riban-bw/I2C-Hardware-Controller/(threads)

Thread 1 (2019-03-10):

Feature: Ability to configure I2C bus address

riban-bw, 2019-03-10:
It may be advantageous to configure the I2C address at boot time instead of at compile time, e.g. using dip switches.

riban-bw, 2019-03-25:
Added boot-time configuration switch inputs. I2C address may be configured to any value in range 0x08 - 0x47,

Closed 2019-03-25.

Thread 2 (2019-03-10):

Feature: Ability to configure controller parameters

riban-bw, 2019-03-10:
It may be advantageous to be able to send I2C messages to the device to configure its behaviour, e.g. to set the threshold and scaling of fast encoder rotation.

Thread 3 (2019-03-10):

Add schematic diagram

riban-bw, 2019-03-10:
The schematic circuit diagram should be added to repository.

riban-bw, 2019-03-25:
Schematic added - wip but progressing.

Closed 2019-03-25.

Thread 4 (2019-03-12):

Do not get full scale value through ADC multiplexer

riban-bw, 2019-03-12:
With a potentiometer turned fully up one would expect the ADC reading to be (2^n)-1 (where n is the quantity of bits), e.g. 0x3ff (1023) for 10-bits. This is true with a potentiometer directly feeding an ADC input pin but when a HCF4051BE multiplexer is inserted between the potentiometer and the ADC input pin then the ADC reads a maximum of 0x3d1 (977).

This may be due to impedance of the multiplexer. Need to check the datasheet and do some old-school Thevenin calculations. May be able to add a scaling factor or define a maximum expected value. May be related to the type of multiplexer chip used (just one in the drawer). It may be due to the resistor matrix arrangement. There may be some optimisation possible via code or hardware.

Thread 5 (2019-03-12):

Potentiometer value can be one off target

riban-bw, 2019-03-12:
Setting potentiomter fully up should result in the highest possible value but sometimes it provides a value one less than maximum. This may be after fast or slow movement but does not always occur.

riban-bw, 2019-03-12:
This seems to be related to the noise filter. Leaving the control alone for a few seconds results in the value changing to the expected value. Might need to review filter code although this might not be a significant problem.

Thread 7 (2019-03-26):

Feature: Disable controllers

riban-bw, 2019-03-26:
It may be advantageous to be able to disable controllers to reduce the risk of unused controllers triggering events. Could use a spare configuration switch to disable / enable all controllers. Could write I2C value to each controller to disable / enable.

This may not be an issue if there is insufficient noise on controllers to trigger false signals.

Thread 8 (2019-04-10):

Multiplexed analogue inputs noisey

riban-bw, 2019-04-10:
When using multiplexed ADC the readings are inconsistent causing excessive (invalid) I2C messages.

riban-bw, 2019-04-10:
It may be advantageous to add sample capacitors to the ADC inputs and use the enable input on each multiplex chip (common enable signal from Matrix Out 4) to form a sample and hold mechanism.

Thread 9 (2019-04-10):

Support Blue Pill STM32 board

riban-bw, 2019-04-10:
The current implementation of I2C HWC supports the Maple Mini STM32 board. It may be advantageous to also support the cheaper Blue Pill STM32 board.

riban-bw, 2019-04-10:
This may be possible using conditional compilation but the Blue Pill joins analogue and digital power which has the potential to increase noise and make ADC readings less accurate. (I am not yet convinced that the Maple Mini clone doesn't do the same thing!) I will try to obtain a Blue Pill board and test.

Thread 10 (2019-04-12):

Add ability to update firmware via I2C

riban-bw, 2019-04-12:
It may be advantageous for the host machine to be able to update the firmware of the I2C HWC. There is already an I2C connection and all other pins are currently utilised. Could we add the ability for firmware update via I2C?

riban-bw, 2019-04-12:
This would require:
- New messaging schema (already in progress)
- Method of writing to flash program memory
- Dual firmware locations within program memory to allow update and switch whilst running firmware
- Bootloader capable of switching between firmware locations
- Robust validation of firmware, ideally with rollback ability in case of bad update

Alternative may be to use existing firmware update methods and switch serial port via host driven signalling e.g. GPI to gate serial port connection.

Thread 12 (2019-04-17):

Feature: Reset device / clear values

riban-bw, 2019-04-17:
It would be advantageous to be able to reset all the values via I2C message.

Closed 2019-04-18.
