riban-bw/I2C-Hardware-Controller/(commit log)

2019-03-10 Add source code (and CodeBlocks project). Potentiometer reading and filtering implemented. Initial switch reading implemented. Encoder and multiplexing not yet implemented.
2019-03-10 Move source code to subfolder to make Arduino IDE happy.
2019-03-10 Add ADC multiplexer. Fixes occasional wrong controller register being sent via I2C. Add some start-up debug (must remove once all working). Extract ADC read to separate function. Remove temporary sim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
    [I2CHWC.ino]
2019-03-10 Avoid one controller hogging I2C bus by scanning from next controller. Allows simultaneous adjustment of several controllers.
    [I2CHWC.ino]
2019-03-10 Implements rotary encoders. Removes debug. De-interleaves ADC. Fixes sending encoder values (which are cleared on get). Enables full compliment of controllers. This commit provides full implementatio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
    [I2CHWC.ino]
2019-03-10 Adds fast scrolling to rotational encoders.
2019-03-11 Fixes ADC mux decoding error. Use fixed size tables for maximum quantity of controllers. Rationalise some constants. Populate time for each type of controller (previously only encoders). Add debounce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
    [I2CHWC.ino]
2019-03-12 Allow exclusion of external ADC multiplexers (maximum of 8 pots). Reverse order of ADCs. Change order of potentiometer controls to be consecutive for each mux or consecutive for each ADC based on USE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
    [I2CHWC.kicad_pcb, I2CHWC.sch]
2019-03-16 Progress schematic and PCB (wip). Allow ADC without multiplexers (max. 8 pots). Explicit use of int16_t for I2C data. Simplify casting for int to byte.
    [I2CHWC.kicad_pcb, I2CHWC.sch, Potentiometers.sch]
2019-03-24 Changes GPI pin assignment. (This may not be the last time - need to review PCB layout.) Change balance of switches / encoders (reduced encoders to 30 and increased switches to 60. Explicitly disable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
2019-03-25 I2C address and ADC Mux configured at boot via switches / links. Change GPI assignment. Now supports automatic detection of ADC Mux via config bit 6 allowing ADC Mux expansion board as optional extra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
    [ADCMUX.sch, I2CHWC.sch]
2019-03-27 Updates circuit schematic and PCB - wip.
    [ADCMUX.sch, I2CHWC.kicad_pcb, I2CHWC.sch, I2CHWC_ADCEXT.kicad_pcb, I2CHWC_ADCEXT.sch, I2CHWC_DIGEXT.kicad_pcb, I2CHWC_DIGEXT.sch]
2019-04-08 Corrects 16-bit signed integer range (encoder value range)
2019-04-10 Firmwware changes: Temporarily disable ADC (whilst investigating noise issues). Change quantity of switches (from 60 to 50). Start implementing I2C commands (wip). Reverse encoder rotation (maybe jus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
    [Encoder.kicad_pcb, Encoder.sch, I2CHWC.kicad_pcb, I2CHWC.sch, I2CHWC_ADCEXT.kicad_pcb, I2CHWC_ADCEXT.sch, I2CHWC_DIGEXT.kicad_pcb, I2CHWC_DIGEXT.sch]
2019-04-18 Implements write functions including reset. Fixes #12.
    [I2CHWC.ino]
